ZELDA-LINK-F/edge-ai-gimbal/images/demo-人脸检测.jpg

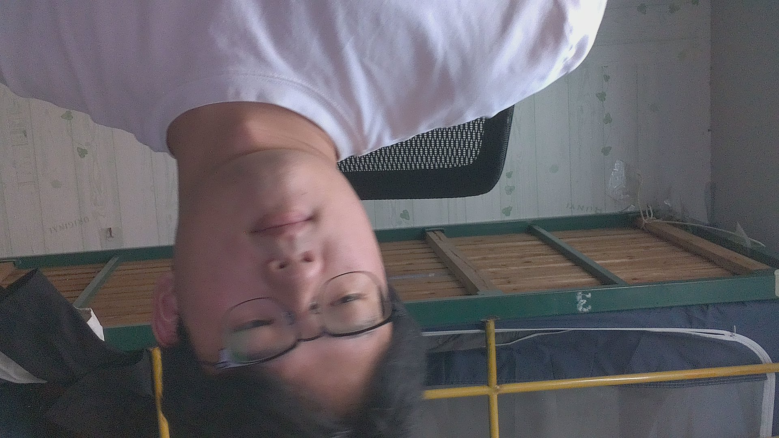
images/demo-人脸检测.jpg
