ZELDA-LINK-F/edge-ai-gimbal/docs/10-执行方案.md

# 10 · 延迟优化执行方案（实测版）

> 产出日期：2026-10-20
> 依据：docs/09-延迟优化方案.md + **2026-10-20 21:00 在板子上的实测**
> 本方案修正 09 的步骤顺序与两处预期值，可直接照做。

---

## 0 · 一句话

**先改三个常数（1 小时，砍掉约 240ms），再接 engine（省 10ms），再上 60fps，最后绕开 ultralytics 才能吃到 4.5ms 的推理。**
09 里"先搞相机管线再搞模型"的顺序要调过来——实测 PyTorch 一帧 30ms，比 60fps 的 16.7ms 帧周期还长，先上 60fps 只会丢帧。

---

## 1 · 实测基线（2026-10-20 21:00，MAXN_SUPER）

| 环节 | 实测 | 备注 |
|---|---|---|
| 相机 1280×720 @30 | grab p50 **33.2ms** / p95 35.3ms，30.1 fps | 消费者快于相机，read 在等帧 |
| 相机 1280×720 @**60** | grab p50 **16.7ms** / p95 17.9ms，**60.0 fps** | 传感器模式 4，原生 59.999fps ✅ |
| `cv2.rotate(180)` | **1.31ms** | 09 写 2.5ms，实测更小 |
| PyTorch `detect_frame` | **30.3ms** p50 / 31.7 p95 | 09 写 27ms，接近 |
| **TensorRT engine via ultralytics** | **19.8ms** p50 / 21.5 p95 | 只比 PyTorch 快 10.5ms |
| **TensorRT 纯计算（trtexec）** | **4.0ms** compute / 4.5ms latency / 250 qps | 640×640 FP16，`lab1/yolov8n_fp16.engine` |
| `/home/nvidia/project/yolov8n.engine` | **加载失败：LLVM ERROR: out of memory** | 坏的，不要用 |
| pycuda | **不需要** | ultralytics 8.3.213 用 `torch`+`tensorrt` API，无 pycuda 依赖 |
| 板子网络 | 无（pypi/阿里/清华源均不可达） | 本方案**不需要装任何包** |
| 环境 | TRT 10.3.0 / torch 2.5-nv / ultralytics 8.3.213 / nvcc 12.6 | |

### 三个由此得出的关键判断

1. **engine 只省 10.5ms，不是 26ms** —— 因为 ultralytics 的前后处理（letterbox + NMS + Python）占了约 **15ms**。
   想拿到 4.5ms 的推理，必须**绕开 ultralytics 自己写 TRT runner**（Phase 4）。
2. **现有 engine 的类别名是 `class0 … class79`**（trtexec 转的，没有元数据）。
   `follow.py` 里 `d["class"] == "person"` **会永远匹配不到** —— 直接接 engine 会让跟随**静默失效**。
   必须先解决（Phase 2）。
3. **60fps 硬件可用**已确认，但只有 loop 能压到 16.7ms 以内才吃得满（P≤8ms 时）。

---

## 2 · 延迟预算（目标值）

| 阶段 | T/2 | E/2 | P | τ | ms | 合计 |
|---|---|---|---|---|---|---|
| 现状（实测推算） | 16.7 | ~7.5 | 31.6 | 116 | 200 | **≈ 372ms** |
| Phase 1 后 | 16.7 | 7.5 | 31.6 | **30** | **50** | **≈ 136ms** |
| Phase 2 后 | 16.7 | 7.5 | **21.1** | 30 | 50 | **≈ 125ms** |
| Phase 3 后 | **8.3** | ~4 | 21.1 | 30 | 50 | **≈ 113ms** |
| Phase 4 后 | 8.3 | 4 | **~9** | 30 | 50 | **≈ 101ms** |
| Phase 5 后 | 8.3 | 4 | ~9 | **0**（前馈抵消） | 50 | **≈ 71ms** |

> P 取"grab 之后的整段处理"，含 rotate。Phase 3 起 remove rotate。
> 以上为估算，每阶段做完用 Phase 0 的打点表覆盖。

---

## Phase 0 · 建基线（半天，必须先做）

### 0.1 给 `follow.py` 加打点

在 `step()` 里插时间戳，每 300 帧打印 p50/p95：

```python
import time, statistics

class Prof:
    def __init__(self, every=300):
        self.d = {}; self.n = 0; self.every = every
    def add(self, k, ms):
        self.d.setdefault(k, []).append(ms)
    def tick(self):
        self.n += 1
        if self.n % self.every: return
        out = []
        for k, v in self.d.items():
            v = sorted(v); n = len(v)
            out.append("%s p50=%.1f p95=%.1f" % (k, v[n//2], v[min(n-1, int(n*0.95))]))
            self.d[k] = []
        print("[prof] " + " | ".join(out), flush=True)
```

`step()` 内：

```python
t0 = time.perf_counter()
ok, frame = self.cap.read()
t1 = time.perf_counter()
if self.flip: frame = cv2.rotate(frame, cv2.ROTATE_180)
t2 = time.perf_counter()
dets, _ = detect_frame(self.model, frame, conf=CONF)
t3 = time.perf_counter()
# ...筛选/映射/限位/发串口...
t4 = time.perf_counter()

self.prof.add("grab",    (t1-t0)*1000)
self.prof.add("rotate",  (t2-t1)*1000)
self.prof.add("infer",   (t3-t2)*1000)
self.prof.add("ctrl+tx", (t4-t3)*1000)
self.prof.add("loop",    (t4-t0)*1000)
self.prof.tick()
```

> 只看均值没有意义，控制环怕的是 p95 抖动。

### 0.2 舵机阶跃响应（`servo_step.py`）

`servo.py` 的 `cmd()` 固定等 0.4~0.6s，不能用来采样。用下面这个直接写串口 + 50ms 轮询读位置：

```python
#!/usr/bin/env python3
"""舵机阶跃响应：S1,<target>,<ms> 之后每 ~50ms 读一次位置"""
import sys, time, serial
from servo import ServoBus  # 复用找端口/限位逻辑

bus = ServoBus()
print("port:", bus.port)

def raw_read(sid):
    bus.s.reset_input_buffer()
    bus.s.write(("R%d\r\n" % sid).encode())
    t0 = time.time(); buf = b""
    while time.time() - t0 < 0.12:
        buf += bus.s.read(256)
    txt = buf.decode("utf-8", "replace")
    for line in txt.splitlines():
        if "字节" not in line: continue
        try:
            data = [int(h, 16) for h in line.split(":")[1].split()]
        except Exception:
            continue
        for i in range(len(data) - 7):
            if data[i:i+3] == [0x55, 0x55, sid] and data[i+3] == 0x05:
                v = data[i+5] | (data[i+6] << 8)
                return v - 65536 if v > 32000 else v
    return None

start, target = 500, 550
bus.s.write(("S1,%d,1000\r\n" % start).encode()); time.sleep(1.5)
for ms in (50, 200):
    bus.s.write(("S1,%d,1000\r\n" % start).encode()); time.sleep(1.5)
    t0 = time.time()
    bus.s.write(("S1,%d,%d\r\n" % (target, ms)).encode())
    samples = []
    while time.time() - t0 < 0.8:
        p = raw_read(1)
        samples.append((round((time.time()-t0)*1000), p))
    print("ms=%d:" % ms, samples)
bus.close()
```

**判读**：从开始到位置到达 `target±2` 的耗时。若 `ms=200` 约 200ms、`ms=50` 约 50ms，
就证明 09 的"ms = 滞后"模型成立，Phase 1 的收益预测可信。

> 采样分辨率受 STM32 的 R 命令限制（内部等 50ms），只能分辨 50ms 级差异。
> 要更准就用手机 240fps 慢动作拍舵机臂，数帧数 × 4.17ms。

### 0.3 记录硬件状态

```bash
sudo nvpmodel -q        # 预期 MAXN_SUPER
sudo jetson_clocks      # 开满频（会变热，注意温度）
```

**产出**：一张实测延迟分解表 → 直接就是报告 6.2 节的新版本。

---

## Phase 1 · 控制参数（1 小时）★ 收益最大

`follow.py`：

```python
SMOOTH  = 0.25   →  TAU = 0.030      # 改成时间常数
MOVE_MS = 200    →  MOVE_MS = 50
                       DEADBAND = 4  # 新增，1° 死区
```

`step()` 改为（完整版，含 dt 自适应与步长保护）：

```python
def step(self, verbose=False):
    t0 = time.perf_counter()
    dt = max(t0 - self.t_prev, 1e-3)
    self.t_prev = t0

    ok, frame = self.cap.read()
    if not ok:
        return None
    if self.flip:
        frame = cv2.rotate(frame, cv2.ROTATE_180)

    dets, _ = detect_frame(self.model, frame, conf=CONF)
    person = self.biggest_person(dets)
    self.frames += 1

    if person:
        self.hits += 1
        x1, y1, x2, y2 = person["box"]
        cx = (x1 + x2) / 2.0
        offset = max(-1.0, min(1.0, (cx - W / 2.0) / (W / 2.0)))
        target = PAN_CENTER + offset * (PAN_MAX - PAN_MIN) / 2.0
    else:
        target = PAN_CENTER

    if abs(target - self.pan) < DEADBAND:
        target = self.pan

    alpha = 1.0 - math.exp(-dt / TAU)
    want = self.pan + (target - self.pan) * alpha

    # 每帧最大步长：保护 FPC 排线，防止大跳变时舵机猛甩
    MAX_STEP = 12.0
    self.pan += max(-MAX_STEP, min(MAX_STEP, want - self.pan))

    self.send_move(self.pan)
    ...
```

- `__init__` 加 `self.t_prev = time.perf_counter()`，文件头补 `import math`
- "没人回中"那一行（`follow.py:131`）的 `400` 也改成 `MOVE_MS`

**验收**：`loop` p50 不变（还是 30ms 左右），但体感明显变快。
**风险**：抖动 → 先把 `DEADBAND` 4→6，不要急着把 `TAU` 调回去。

---

## Phase 2 · engine 接线（半天）

### 2.1 先解决类别名（不解决 = 跟随静默失效）

两个办法，任选：

**A. 用 ultralytics 重新导出一个带元数据的 engine（推荐）**

```python
from ultralytics import YOLO
YOLO("yolov8n.pt").export(format="engine", imgsz=640, half=True, batch=1, workspace=4, device=0)
```

**B. 继续用 `lab1/yolov8n_fp16.engine`，手工映射名字**

```python
COCO80 = [...]  # 标准 COCO 类名列表
m = YOLO("/home/nvidia/project/lab1/yolov8n_fp16.engine")
if getattr(m, "names", {}).get(0) == "class0":
    m.names = {i: n for i, n in enumerate(COCO80)}
```

> 验证方法：打印检测结果，确认 `d["class"] == "person"` 能命中。

### 2.2 模型路径

`detect.py`：

```python
DEFAULT_MODEL = os.environ.get("GIMBAL_MODEL", "yolov8n.pt")

def load(path=DEFAULT_MODEL):
    from ultralytics import YOLO
    if path.endswith(".engine") and not os.path.exists(path):
        print("[detect] 找不到 %s，回退到 yolov8n.pt" % path)
        path = "yolov8n.pt"
    return YOLO(path)
```

启动：`GIMBAL_MODEL=/home/nvidia/project/lab1/yolov8n_fp16.engine python3 follow.py`

⚠️ **不要**用 `/home/nvidia/project/yolov8n.engine` —— 那个文件加载直接 `LLVM ERROR: out of memory`。

### 2.3 删掉每帧 180° 旋转

删 `follow.py:109-110` 两行，改成 `if self.flip: offset = -offset`（180° 只影响水平方向）。

**验收**：`infer` p50 ≈ **20ms**（不是 4.5ms，ultralytics 开销还在）；
打印能稳定看到 `person`。
**反作用**：无（数学等价）。

---

## Phase 3 · 相机 60fps（2 小时）

`follow.py` 与 `camera.py` **两条管线都要改**（`detect.py camera` 用的是 `camera.py.frames()`）：

```python
W, H = 1280, 720
FPS = 60
pipeline = (
    "nvarguscamerasrc sensor-id=0 aeantibanding=2"
    " exposuretimerange=\"1000 8000000\" gainrange=\"1 16\""
    " ! video/x-raw(memory:NVMM),width=%d,height=%d,framerate=%d/1,format=NV12"
    " ! nvvidconv ! video/x-raw,format=BGRx ! videoconvert"
    " ! video/x-raw,format=BGR ! appsink drop=1 max-buffers=1 sync=false"
    % (W, H, FPS)
)
```

| 改动 | 收益 |
|---|---|
| framerate 30→60 | T/2 16.7 → 8.3ms |
| max-buffers 2→1 | 消除最多 1 帧的排队 |
| sync=false | 不跟管线时钟 |
| exposure 上限 8ms | 暗光下自动曝光不会拉满一帧 |
| 删 rotate | 1.3ms |

**验收**：`grab` p50 ≈ **16.7ms**；`loop` ≈ 23ms（P=20 时跟不上 60fps，但不影响取最新帧）。
**风险**：曝光压太短 → 噪点、远处漏检。先在现场亮度下测 100 帧检出率；掉得多就把上限放到 12ms。

---

## Phase 4 · 自定义 TRT runner（1 天）★★ 第二收益

**为什么**：19.8ms 里有 15ms 是 ultralytics 的 letterbox/NMS/Python。自己写可以压到 **~8ms**。

要做的四件事：

1. **预分配**：一次创建 `IExecutionContext` + 固定输入输出显存，循环里不再 malloc。
2. **预处理进 GPU**：`cv2.resize` 到 640×640（或 640×360 + padding）后 `cudaMemcpy`，
   或者用 CUDA 核直接 BGR→RGB float CHW 写进 binding。
3. **后处理向量化**：输出 `1x84x8400` → numpy 一次算完 `conf = obj * cls`，`np.where(conf > thres)`，
   不要写 Python 循环。
4. **NMS**：`cv2.dnn.NMSBoxes` 或 torchvision（板子上都有）。

**验收**：`infer` p50 **< 10ms**；同一批图与 ultralytics 版检出框一致（IoU 比对）。
**风险**：NMS/坐标还原写错 → 框偏移。用 10 张固定图做回归对比。

---

## Phase 5 · 前馈（半天）

```python
# 目标速度估计（低通必须有）
raw_v = (target - self.target_prev) / dt
self.v = 0.75 * self.v + 0.25 * raw_v
self.target_prev = target

LEAD = TAU                       # 先用 30ms
lead = max(PAN_MIN, min(PAN_MAX, target + self.v * LEAD))

alpha = 1.0 - math.exp(-dt / TAU)
self.pan += (lead - self.pan) * alpha
```

**验收**：匀速横穿画面时稳态误差 ≈ 0，不振荡。
**风险**：框抖动被放大 → 低通不能省；目标消失瞬间 `lead` 必须 clamp（否则冲出去）。

---

## Phase 6 · INT8（可选，1~2 天，价值在简历）

1. 板子上抓 300~500 张**现场真实帧**（不同光照/距离/人数）
2. `YOLO("yolov8n.pt").export(format="engine", imgsz=640, int8=True, data="calib.yaml", batch=1, workspace=4)`
3. 精度报告：mAP 掉多少、掉在哪几类、怎么补救

**验收**：推理 < 5ms；mAP 掉点 < 1%（以实测为准）。

---

## 4 · 总验收：物理端到端

**最有说服力、也最难造假的一个数**：

1. 手机 240fps 慢动作，同时拍「手划过画面中线」和「舵机转过中线」
2. 数中间隔了几帧 × 4.17ms
3. 与打点推算的 `loop + ctrl` 交叉验证

报告 6.2 改成「数值 + 口径」两列（见 09 第 7 节）。

---

## 5 · 风险清单

| 风险 | 影响 | 对策 |
|---|---|---|
| MOVE_MS=50 冲击 FPC 排线 | 排线断 = 摄像头报废 | 保留 400~600 限位 + Phase 1 的 MAX_STEP 步长保护 |
| engine 无元数据 | 找不到 person，跟随静默失效 | Phase 2.1 重导或映射名字，**必须验证** |
| 坏 engine | 加载即崩（LLVM OOM） | 只用 `lab1/yolov8n_fp16.engine` 或新导出的 |
| 曝光压到 8ms | 暗处噪点/漏检 | 现场亮度下测检出率，必要时放到 12ms |
| 60fps 与 AE 打架 | 画面闪烁/变暗 | `aeantibanding=2`，必要时固定曝光+增益 |
| 死区+低 τ 抖动 | 画面/舵机轻微抖 | 先加 DEADBAND 到 6，别回调 TAU |
| 板子无网 | 装不了任何包 | 本方案零依赖，全部用现有包 |

---

## 6 · 与 09 的差异（重要）

| 项 | 09 原方案 | 本方案 | 原因 |
|---|---|---|---|
| 顺序 | Step1 → **Step2(相机)** → Step3(engine) | Step1 → **Step3(engine)** → Step2(相机) | PyTorch 30ms > 60fps 帧周期，先上 60fps 只会丢帧 |
| engine 收益 | 27 → 12ms（估） | **30.3 → 19.8ms（实测）**；自定义 runner 再 → ~8ms | ultralytics 前后处理占 15ms |
| pycuda | 需要装 | **不需要** | ultralytics 8.3.213 用 torch+TRT API |
| engine 选择 | `yolov8n.engine` | **`lab1/yolov8n_fp16.engine`** 或重导 | 项目根目录那个是坏的 |
| rotate 开销 | 2.5ms | 1.31ms（实测） | — |
| PyTorch 推理 | 27ms | 30.3ms（实测） | — |

---

## 7 · 建议排期

| 顺序 | 阶段 | 估时 | 累计延迟 |
|---|---|---|---|
| 1 | Phase 0 基线 | 0.5 天 | 372ms（基线） |
| 2 | Phase 1 控制参数 | 1 小时 | ~136ms |
| 3 | Phase 2 engine | 0.5 天 | ~125ms |
| 4 | Phase 3 60fps | 2 小时 | ~113ms |
| 5 | Phase 4 自定义 runner | 1 天 | ~101ms |
| 6 | Phase 5 前馈 | 0.5 天 | **~71ms** |
| 7 | Phase 6 INT8（可选） | 1~2 天 | 报告价值 |

**最快见效路径**：Phase 0 + Phase 1（大半天）就能从 372ms 到 ~136ms，这就是面试里最能讲的一段。

---

## 8 · 执行结果（2026-10-20 实测）

### 已完成

| 阶段 | 状态 | 结果 |
|---|---|---|
| Phase 0 基线 | ✅ | `follow.py --profile` 内置分段打点；`servo_step.py` 已备好（**待舵机实测，本轮未跑**） |
| Phase 1 控制参数 | ✅ | `TAU=0.030` / `MOVE_MS=50` / `DEADBAND=4` / `MAX_STEP=12` |
| Phase 2 engine | ✅ | 默认走 TensorRT；类别名 `classN→COCO80` 已映射 |
| Phase 3 相机 60fps | ✅ | 60fps + GPU 缩放到 640×360 + 曝光上限 8ms + max-buffers=1 |
| Phase 4 自定义 TRT runner | ✅ | `trt_runner.py`，**7.4ms**（ultralytics 19.8ms，PyTorch 30.3ms） |
| Phase 5 前馈 | ✅ 代码 | 待舵机实测验证稳态误差 |
| Phase 6 INT8 | ⬜ | 需要现场校准图，未做 |

### 实测数字（`sudo jetson_clocks` 之后）

| 项 | 数值 |
|---|---|
| 纯推理 | **7.4ms** @640×640，7.7ms @1280×720（135 FPS） |
| 跟随循环 | grab **5.7ms** / infer **10.0ms** / loop **15.7ms** → **63 fps** |
| 相机 | 60fps 稳定（sensor mode 4） |
| 检测一致性 | bus.jpg：3 人 + 1 公交，与 ultralytics 版一致（边界那个 conf≈0.43 的目标掉到阈值下） |

### ⚠️ 关键前提

**`sudo jetson_clocks` 必须执行**。不执行时 GPU/EMC 动态降频，infer 从 10ms 变成 21ms。
重启后失效，需要重新跑（或用 systemd 服务固定）。

### 延迟估算更新

`D ≈ T/2(8.3) + E/2(≈4) + P(10) + ms(50) + 总线(2) ≈ **75ms**`（前馈开启，τ 被抵消）；
关掉前馈约 105ms。物理端到端仍需 §4 的慢动作法实测。

### 还剩什么

1. `servo_step.py` 实跑一次，把「ms=200/50」的真实到位时间填进表（会动舵机）。
2. 带舵机跑一次跟随，验证前馈不振荡、`MAX_STEP` 不甩。
3. 物理端到端慢动作测量。
4. （可选）INT8。
