ZELDA-LINK-F/edge-ai-gimbal/docs/06-云台跟随.md

# 云台跟随

## 核心逻辑

```
摄像头帧 (1280×720)
    ↓
[180° 翻转]   ← 摄像头装反了
    ↓
YOLO 检测
    ↓
找最大的 person
    ↓
算水平中心 cx
    ↓
归一化偏移 offset = (cx - 640) / 640   → [-1, +1]
    ↓
目标位置 target = 500 + offset × (PAN_MAX - PAN_MIN) / 2
    ↓
平滑滤波 pan = pan + (target - pan) × SMOOTH
    ↓
安全限位 clamp(pan, 400, 600)
    ↓
串口发送 "S1,<pan>,200"
    ↓
舵机转动
```

---

## 关键参数

```python
W, H = 1280, 720          # 检测分辨率
CONF = 0.4                # 置信度阈值
UPSIDE_DOWN = True        # 180° 翻转（摄像头装反时用）

PAN_ID = 1                # 水平舵机 ID
PAN_MIN, PAN_MAX = 400, 600   # 安全限位
PAN_CENTER = 500          # 中位
SMOOTH = 0.25             # 平滑系数
MOVE_MS = 200             # 舵机运动时间
```

### 平滑系数 SMOOTH 怎么调

| 值 | 效果 |
|---|---|
| 0.1 | 很平滑，但有滞后 |
| **0.25** | **平衡（推荐）** |
| 0.5 | 灵敏，但可能抖动 |
| 1.0 | 每帧直接到位（可能抖动/异响） |

---

## 安全限位（重要）

**摄像头 FPC 排线不能反复弯折**，所以默认限制在 ±24°：

```python
PAN_MIN, PAN_MAX = 400, 600     # ±100 单位 = ±24°
```

### 角度换算

```
位置 0~1000  →  0~240°
1 单位  =  0.24°
±100 单位  =  ±24°
```

### 需要更大角度时

```python
# 1. 先确认排线走线有余量（靠近转轴 + 固定根部）
# 2. 再逐步放宽
PAN_MIN, PAN_MAX = 350, 650     # ±36°
```

### 临时绕过限位

```python
bus.move(1, 300, bypass=True)   # 强制超出安全范围
```

---

## 实测结果

### 测试 1（摄像头固定，验证逻辑）

```
总帧数: 4121
检测到人: 4121 (100%)
人的 x 范围: 410 ~ 971
舵机范围: 465 ~ 552
摆动: 87 单位
```

### 测试 2（摄像头调好后）

```
总帧数: 3509
检测到人: 3509 (100%)
人的 x 范围: 346 ~ 1055  (跨画面 55% 宽度)
舵机范围: 454 ~ 563
摆动: 109 单位 (~26°)
```

**100% 检测率，舵机实时跟随。**

---

## 使用方法

```bash
cd /home/nvidia/project

# 跟随模式（Ctrl+C 退出）
python3 follow.py

# 跑指定帧数
python3 follow.py --frames 100

# 跑指定秒数
python3 follow.py --seconds 120

# 只检测，不动舵机
python3 follow.py --no-servo

# 摄像头装正了（不翻转）
python3 follow.py --no-flip
```

---

## 性能

| 环节 | 耗时 |
|---|---|
| YOLO 推理 | 27ms |
| 偏移计算 | <1ms |
| 串口发送 | <1ms |
| 舵机响应 | ~20ms |
| **端到端** | **< 50ms** |

帧率：**37 FPS**

---

## 完整跟随代码（核心部分）

```python
def step(self):
    ok, frame = self.cap.read()
    if not ok:
        return
    if self.flip:
        frame = cv2.rotate(frame, cv2.ROTATE_180)

    dets, dt = detect_frame(self.model, frame, conf=0.4)
    person = self.biggest_person(dets)

    if person:
        x1, y1, x2, y2 = person["box"]
        cx = (x1 + x2) / 2.0
        offset = max(-1.0, min(1.0, (cx - 640) / 640.0))
        target = 500 + offset * (600 - 400) / 2.0
        self.pan = self.pan + (target - self.pan) * 0.25

        # 快速发送（不等应答）
        p, _ = self.bus.clamp(1, self.pan)
        self.bus.s.write(("S1,%d,200\r\n" % p).encode())
    else:
        # 没人 → 慢慢回中
        self.pan = self.pan + (500 - self.pan) * 0.1
        self.bus.s.write(("S1,%d,400\r\n" % int(self.pan)).encode())
```

---

## 为什么用「快速发送」而不是 `bus.move()`

`bus.move()` 会等待舵机应答（约 400ms），太慢，跟不动。

跟随循环里直接写串口，不等应答：

```python
self.bus.s.write(("S1,%d,200\r\n" % p).encode())
```

同时每 2 秒清一次接收缓冲（固件会回显 `TX:` / `OK` / `HELLO`）：

```python
def drain(self):
    if time.time() - self.last_drain > 2.0:
        self.bus.s.reset_input_buffer()
        self.last_drain = time.time()
```

---

## 下一步：真正的云台

**当前**：摄像头固定，舵机空转（逻辑验证）

**目标**：摄像头装在舵机上

```
摄像头 → 支架 → 舵盘 → 舵机 → 底板
```

机械固定方案见 [02-硬件接线.md](02-硬件接线.md) 的「摄像头排线注意事项」。
