ZELDA-LINK-F/edge-ai-gimbal/docs/08-性能地图.md

# 边缘 AI 性能地图（Jetson Orin Nano 8GB · 实测）

> 产出日期：2026-10-15 ｜ 阶段 B 交付物
> **所有数字都是这台机器上实测的**，不是估的、不是抄的。
> 用法：以后要选模型 / 调参数 / 判断"跑不跑得动"，先查这张表。

---

## 0 · 三条铁律（先记住这些，再看数字）

### ① 全 GPU > 全 CPU > **混合（最差）**

Q4 模型三种分层的实测：

| 配置 | 生成速度 | 说明 |
|---|---|---|
| **全 GPU**（28/28 层） | **29.0 tok/s** ⚡ | 最快 |
| 全 CPU（0/28 层） | 17.3 tok/s | 竟然不慢 |
| **混合**（26/28 层，出厂默认） | **16.2 tok/s** 😑 | **最慢** |

**原因**：混合模式下每生成一个 token 都要在 CPU↔GPU 之间搬运数据，同步开销吃掉收益。
⇒ **要么全给 GPU，要么全给 CPU，别"各一半"。**

### ② 真正该盯的是「提示处理」，不是生成速度

```
提示处理耗时（同样 38 token 的提示）：
   全 CPU：1434 ms
   全 GPU： 104 ms      ← 快 14 倍
```

生成速度只差 1.8 倍，**提示处理差 14 倍**。
短提示看不出来；一旦 RAG 往提示里塞几块资料（上千 token），差距会被放大成"能不能用"。

### ③ 8GB 上没有"同时"，只有"轮流"

实测：qwen-fast 占着 2.1GB 时，再加载 Q8 模型 → **直接失败**：

```
error loading model: unable to allocate CUDA0 buffer
```

即使 free 显示还有 3.1GB 可用 —— 因为 **CUDA 需要连续物理内存块**，碎片化就分配不出来。

**正确姿势**：换模型前先执行 `ollama stop <旧模型>`。

---

## 1 · 系统基线（不含模型）

| 项 | 实测值 | 备注 |
|---|---|---|
| 总内存 | 7.62 GB | CPU/GPU **共享**（统一内存） |
| 已用 / 可用 | **2.3 G / 4.8 G** | 空闲状态 |
| 空闲功耗 | **5.3 W** | 边缘设备的优势 |
| 空闲温度 | 50~51 °C | |
| Swap | zram ×6（约 0.8G 被用） | 压缩内存，曾是内存紧张的证据 |
| GPU 空闲频率 | 305 MHz（最高 1020 MHz） | |

### 内存都被谁占了（空闲时）

| 谁 | 占用 | 能否省 |
|---|---|---|
| Linux 系统基础 | ~1.0 G | ❌ |
| **桌面 GUI**（gnome-shell/Xorg/gnome-software） | **~450 M** | ✅ 远程开发可关 |
| Open WebUI 容器 | 362 M | ⚠️ 不用可停 |
| semantic-router（判难度+RAG） | 147 M | ⚠️ 停了要重付 330ms+1.8G |
| jupyter-lab | 49 M | ⚠️ |
| dockerd + containerd | 60 M | ⚠️ |
| 其他 | ~0.3 G | |

---

## 2 · 模型性能表 ⭐（核心）

### 文本模型

| 模型 | 量化 | 权重 | num_gpu | 加载后内存 | 生成速度 | 提示处理 | 结论 |
|---|---|---|---|---|---|---|---|
| **qwen-fast**（qwen2.5:1.5b） | Q4_K_M | 986 MB | 0（全CPU） | **1.1 GB** | 17.3 tok/s | 1434 ms | 省内存，长提示慢 |
| **qwen-fast** | Q4_K_M | 986 MB | 26（出厂） | 2.1 GB | 16.2 tok/s | 140 ms | ⚠️ 最慢，但**最稳** |
| **qwen-fast** | Q4_K_M | 986 MB | 28（全GPU） | 1.9 GB | **29.0 tok/s** ⚡ | **104 ms** ⚡ | **性能最优** |
| qwen2.5:1.5b-instruct | **Q8_0** | 1.6 GB | 28（全GPU） | ❌ **加载失败** | — | — | 内存不够 |
| qwen2.5:1.5b-instruct | Q8_0 | 1.6 GB | 20 | ❌ **加载失败** | — | — | 内存不够 |
| qwen2.5:1.5b-instruct | Q8_0 | 1.6 GB | 12 | 2.8 GB | 11.7 tok/s | 92 ms | 能跑但慢（40% 溢出 CPU） |

**⚠️ 为什么出厂默认是 26 层而不是 28？**

查前人笔记（坑 #1）：**全 GPU 时模型会偶发崩溃**（NaN logits → SIGABRT），降到 26 层后稳定（复现器 12/12 崩 → 0/12）。
⇒ **这个 26 是一个"稳定性补丁"，不是性能调优。** 想换 28 层前，先接受"可能偶发崩溃"的风险。

### 视觉模型（前人实测，可直接参考）

| 模型 | 加载后内存 | 速度 | 中文 | 结论 |
|---|---|---|---|---|
| **granite3.2-vision:2b**（num_ctx=2048） | **3.2 GB** | ~19 tok/s | ❌ | ✅ **8GB 上最舒服的选择** |
| qwen2.5vl:3b | 5.8 GB | 慢 | ✅ | 60% 溢出 CPU，勉强 |
| gemma3:4b | 5.5 GB | 慢 | ✅ | 同上 |
| llava:7b | 6.1 GB | — | — | 不崩但胡言乱语 |
| moondream | 2.8 GB | — | — | ❌ 实测崩溃 |

**一句话**：8GB 做**中文**视觉，要么忍（慢+溢出），要么外包给云端 API。

---

## 3 · token 成本表

| 项 | 实测值 | 说明 |
|---|---|---|
| **固定开销** | **~30 token / 次** | 聊天模板（系统提示+角色标记），短句几乎全是它 |
| **中文** | **0.60 token / 汉字** | ⚠️ **因文本而异**：前人测技术笔记是 0.87 |
| **英文** | 0.21 token / 字符 | ≈ 4.8 字符/token |
| 上下文窗口 | 4096（实际使用） | 模型上限 32768，但 KV 缓存吃内存 |

**换算示例**：1500 token 的历史预算 ≈ **2500 个汉字**。

---

## 3.5 · ⚠️ 内存碎片：最容易被忽略的坑

**现象**：反复加载/卸载模型后，即使 `free` 显示还有 3~5G 可用，加载模型仍报
`unable to allocate CUDA0 buffer`。

**原因**：CUDA 需要**连续的物理内存块**。长时间运行后内存池碎片化，大块分配失败。

**诊断指标**：tegrastats 里的 `lfb`（最大连续空闲块）
```
清理前：lfb 2x4MB      可用 3.2G
清理后：lfb 152x4MB    可用 5.0G     ← 一条命令救回来
```

**解法**
```bash
sudo sysctl vm.drop_caches=3     # 释放页缓存（首选，秒级生效）
ollama stop <旧模型>             # 换模型前先卸载
# 还不行 → 重启板子（最彻底）
```

---

## 3.6 · 视觉模型实测（C1 阶段数据）

| 项 | 实测 |
|---|---|
| 模型 | granite3.2-vision:2b（num_ctx=2048） |
| 加载后内存 | **3.2 GB**（100% GPU） |
| 加载耗时 | **10.0 s**（文本模型只要 3s） |
| **一张 1024 宽图片** | **2048 token**（正好占满上下文） |
| 生成速度 | 24.7 tok/s |
| 3840×2160 原图 | ❌ 段错误崩溃 |

⇒ **一张图就吃掉整个上下文预算。做视觉应用前先算 token 账。**

---

## 4 · 场景选择建议

| 你要做的事 | 推荐配置 | 理由 |
|---|---|---|
| 日常闲聊、短问答 | qwen-fast，num_gpu 26（保持默认） | 稳定优先，速度已够 |
| 长提示（RAG 塞资料） | qwen-fast，**全 GPU（28）** | 提示处理 104ms vs 1434ms |
| 内存极度紧张 | qwen-fast，**全 CPU（0）** | 只占 1.1 GB，速度损失可接受 |
| 需要更高精度 | Q8 + num_gpu 12 | 只能部分卸载，速度掉到 11.7 tok/s |
| 看图 | granite3.2-vision:2b + num_ctx=2048 | 占 3.2 GB，仅英文 |
| 中文看图 | ❌ 本机吃力 → 走云端 | — |
| 同时跑多个模型 | ❌ 不行 | 必须 ollama stop 分时 |

---

## 5 · 自己复测的方法

```bash
# 看当前加载状态（含 CPU/GPU 分层）
ollama ps

# 换模型前先卸载（释放内存）
ollama stop <模型名>

# 测一次，拿真实 token 数与耗时
curl -s http://127.0.0.1:11434/api/generate -d @/tmp/req99.json
#   ↑ 关键字段：prompt_eval_count / eval_count / *_duration

# 看系统总体
free -h
sudo tegrastats --interval 1000
```

> 实验用的请求文件我留在板子的 /tmp/ 里（req0 / req26 / req99 / q8_12 等），可以直接复用。

---

## 6 · 阶段 B 小结

**在 8GB 的统一内存上，一切性能问题最后都归结为一句话：**

> **速度 × 内存 × 稳定性 —— 三者只能取其二。**

- 想快 → 全 GPU，但内存多花 0.8G，且可能触发崩溃
- 想省内存 → 全 CPU，但长提示要等 1.4 秒
- 想稳 → 用出厂的 26 层，接受只有一半速度

---

## 7 · 8GB 内存管理策略（Playbook）

### 7.1 先认清约束（这是设计约束，不是 bug）

| 约束 | 含义 |
|---|---|
| **统一内存** | 7.62G 由 CPU/GPU **共享**，没有独立显存 |
| **CUDA 要连续物理块** | 内存碎片会导致"**假性 OOM**"（看着够、就是分配不出来） |
| 内存不可扩展 | 不像 PC 能加内存条 |
| 功耗极低（空闲 5.3W） | 可以 24 小时常开，这是它的优势 |

### 7.2 预算分层：谁可以动

| 层 | 典型占用 | 策略 |
|---|---|---|
| 系统基础 | ~1.0 G | ❌ 不可动 |
| 桌面 GUI | ~450 M | ✅ **最大单笔收益**（远程开发就关掉） |
| 常驻服务 | 判难度器 147M / Open WebUI 362M / jupyter 49M / docker 60M | ⚖️ 按"用不用得上"取舍 |
| **模型（按需）** | 1.1 ~ 3.2 G | 🔄 **一次只留一个** |
| 计算余量 | 剩余 | ⚠️ 至少留 500M~1G |

**额度公式**：`能给模型的内存 ≈ available − 500M（安全余量）`

### 7.3 六条原则

1. **大块优先** —— 全 GPU 或全 CPU，**别混合**（混合最慢，实测 16.2 vs 29.0 tok/s）
2. **分时而非并行** —— 8GB 上"同时"是奢侈品，一次只驻留一个模型
3. **量化优先** —— **Q4 是这台机器的甜点**；Q8 内存翻倍且可能直接装不下
4. **碎片要回收** —— drop_caches 先试，还不行就重启
5. **常驻要算账** —— 常驻 = 用内存换延迟（判难度器 147M 换掉 330ms 重载，值）
6. **算不到就外包** —— 本地+云端路由 = **架构级省内存**

### 7.4 工具箱（八种手段）

| 手段 | 做法 | 省下 | 代价 |
|---|---|---|---|
| 关桌面 GUI | systemctl set-default multi-user.target | ~450 M | 没图形界面 |
| 释放页缓存 | sysctl vm.drop_caches=3 | 整理碎片（lfb 8M→608M） | 无（缓存会重建） |
| 卸载模型 | ollama stop 模型名 | 1~3 G | 下次重载 3~10s |
| 降分层 | num_gpu 调小 | 0.8~1 G | 速度变慢 |
| 缩上下文 | num_ctx 调小 | 线性节省 KV 缓存 | 能塞的资料变少 |
| 降量化 | Q8 → Q4 | 权重 ~50% | 精度略降 |
| 缩小图片 | 缩到 1024 宽以内 | 视觉 token | 细节变少 |
| 分时加载 | 用完就卸 | 全部 | 切换有延迟 |

### 7.5 遇事怎么办（决策树）

```
模型跑不起来
   │
   ├─ ① free -h 看 available
   │     └─ 不够 → 关非必需品（桌面 GUI / Open WebUI / jupyter）
   │
   ├─ ② 明明够却失败 → tegrastats 看 lfb（碎片）
   │     └─ sysctl vm.drop_caches=3 → 还不行就重启
   │
   ├─ ③ 还不行 → 降配置：num_gpu ↓ → num_ctx ↓ → 量化精度 ↓ → 换更小模型
   │
   └─ ④ 还不行 → 换架构：分时加载 / 本地+云端路由
```

### 7.6 这台机器的实测可行配置

| 场景 | 配置 | 模型占用 | 总占用 | 余量 | 可行 |
|---|---|---|---|---|---|
| 纯文本对话 | qwen-fast，num_gpu 26 | 2.1 G | ~4.5 G | 3.1 G | ✅ |
| RAG 长提示 | qwen-fast，全 GPU | 1.9 G | ~4.3 G | 3.3 G | ✅ |
| 看图 | granite-vision，num_ctx 2048 | 3.2 G | ~5.5 G | 2.1 G | ✅ |
| 语音 + 对话同时 | ASR(3.0G) + LLM(2.1G) | — | >8 G | — | ❌ **必须分时** |

### 7.7 前辈的架构本身就是一套内存管理方案

| 他们的设计 | 省下了什么 |
|---|---|
| 判难度器**常驻**（147M） | 避免每次重载编码器（1.8G / 330ms） |
| 闲聊走本地小模型 | 避免为一句"你好"动用大模型 |
| **ASR 空闲 900s 自退** | 用完把 3 GB 还给系统 |
| RAG 只取 **top-3** | 限制提示长度 = 限制 KV 缓存 |
| 复杂问题才走云端 | 根本不在本地占内存 |

**这五条，每一条都是"内存换体验"的具体决策 —— 这才是边缘 AI 的工程能力。**

### 7.8 心法

> **内存管理的本质不是"优化"，是"取舍"。**
> **速度 × 内存 × 稳定性 —— 三者只能取其二。**
