ZELDA-LINK-F/edge-ai-gimbal/(commit log)

2026-10-17 feat: 边缘AI云台跟随系统 - 初始版本
    硬件: Jetson Orin Nano Super + STM32F103VET6 + LX-16A x2
    软件:
    - STM32 裸机固件 (4.5KB, 无 HAL 依赖)
    - LX-16A 总线舵机协议实现 (位置/ID/读回)
    - Jetson 视觉 (IMU219 + YOLOv8n TensorRT 37FPS)
    - 云台跟随算法 (100% 检测率, ±1 定位精度)
    - 自动烧录工具 (FlyMcu 自动化)
    实测: 3509 帧 100% 检测, 舵机跟随 109 单位摆动
2026-10-17 docs: 添加项目工作总结（就业风格 PDF + DOCX）
2026-10-17 chore: 移除重复的报告文件，统一到 report/ 目录
2026-10-17 docs: 项目工作总结扩充为详细版（37页）
    新增内容:
    - 二、技术栈详解: 硬件规格表、软件依赖版本、选型对比
    - 三、系统架构与工作原理: 分层设计、协议、算法
    - 四、详细实现: 硬件/固件/视觉/工具全流程
    - 五、技术难点: 扩充到 8 个（含排查过程与教训）
    - 六、测试与验证: 测试方法、性能数据、功能验证
    - 附录: 引脚表、命令速查、参考文献
2026-10-20 docs: 新增延迟优化方案（09）
    - 延迟模型：D ≈ T/2 + E/2 + P + τ + ms + 2ms，现有参数约 372ms
    - 关键结论：推理只占 <8%，大头在 SMOOTH=0.25（τ=116ms）与 MOVE_MS=200
    - 六步方案：建基线 → 控制参数 → 相机管线 → 预处理/模型输入 → 前馈 → INT8
    - 附累计预期、反作用说明、验收清单、报告指标口径建议
    - README 目录树补上 08-性能地图、09-延迟优化方案
2026-10-20 perf: 云台跟随延迟优化（估算 372ms → ~75ms）
    - detect: 默认走 TensorRT 自定义 runner，纯推理 7.4ms（原 PyTorch 30.3ms / ultralytics TRT 19.8ms）
    - detect: 无元数据 engine 的 classN -> COCO80 类别名映射（否则 follow 找不到 person）
    - follow: 时间常数滤波 TAU=30ms / MOVE_MS=50 / 死区 4 / 每帧步长保护 / 前馈
    - follow: 相机 60fps + GPU 缩放到 640×360 + 曝光上限 8ms + 去掉逐帧 180° rotate
    - follow: --profile 分段打点（grab/infer/ctrl/loop p50/p95）
    - camera: 流式取帧改 60fps
    - 新增 trt_runner.py（自定义 TRT 推理）、servo_step.py（舵机阶跃测量）
    - 新增 docs/10-执行方案.md（实测版执行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
